westlicht/performer-hardware/(notices)

Notices in the files:
sequencer.sch:
cc-by-nc-sa
sequencer.kicad_pcb:
cc-by-nc-sa Simon Kallweit 2018
